AndreaFilippini/QLockTwo-Italian/Images/BackMatrix.jpg

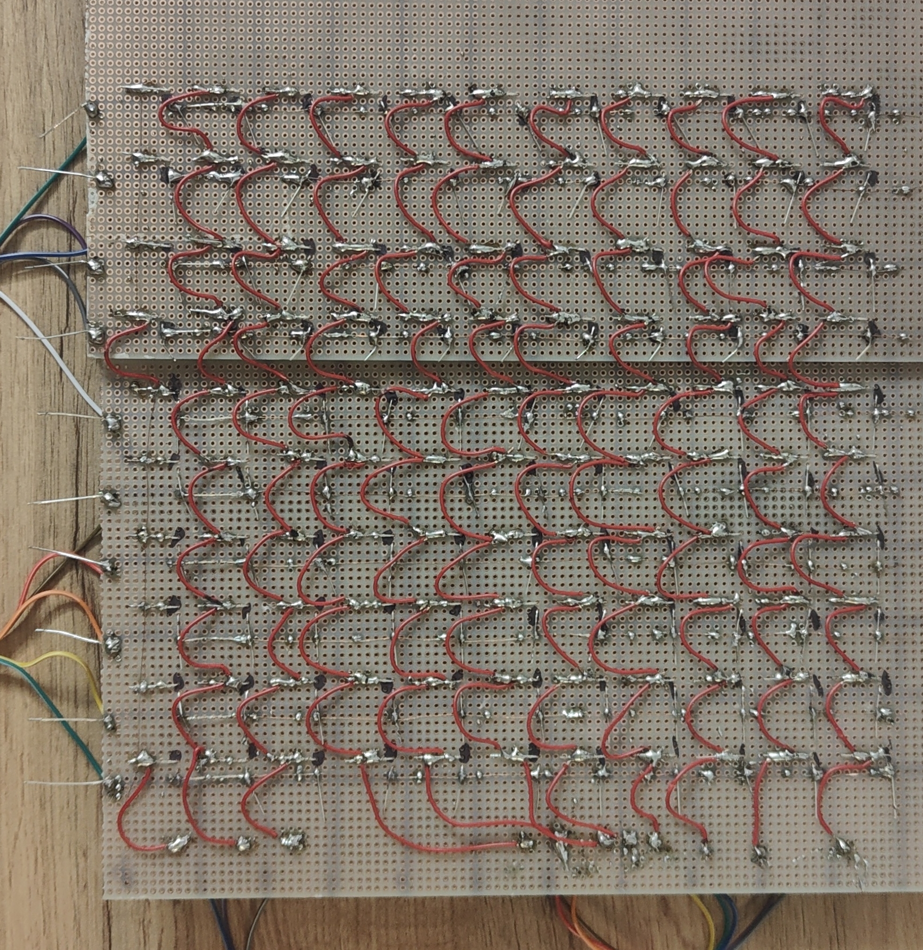
Images/BackMatrix.jpg
