AndreaFilippini/QLockTwo-Italian/Images/FrontMatrix.jpg

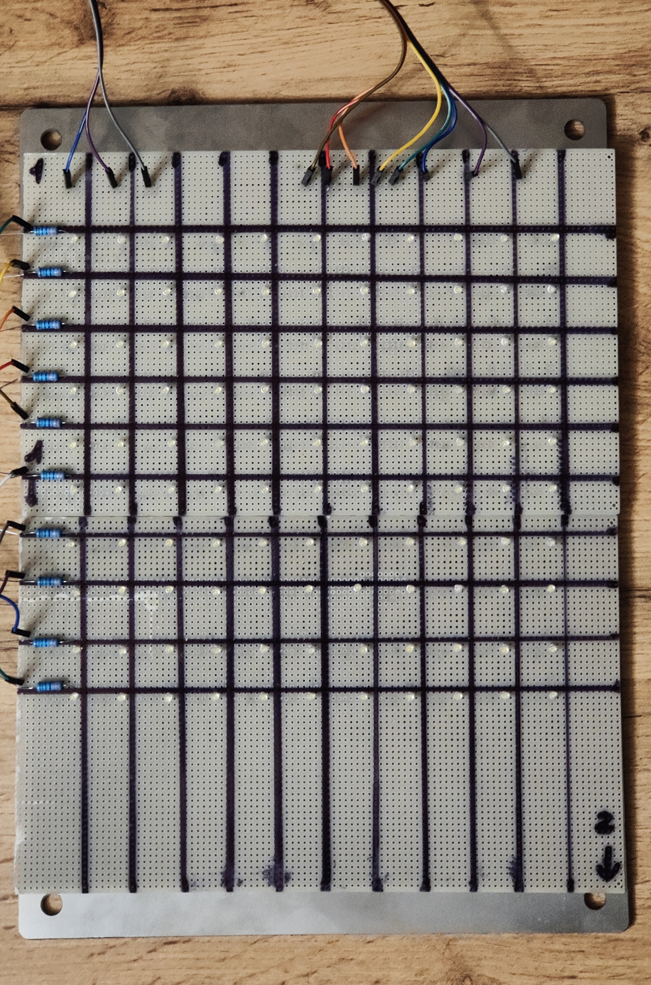
Images/FrontMatrix.jpg
