AndreaFilippini/QLockTwo-Italian/QlockFront.png

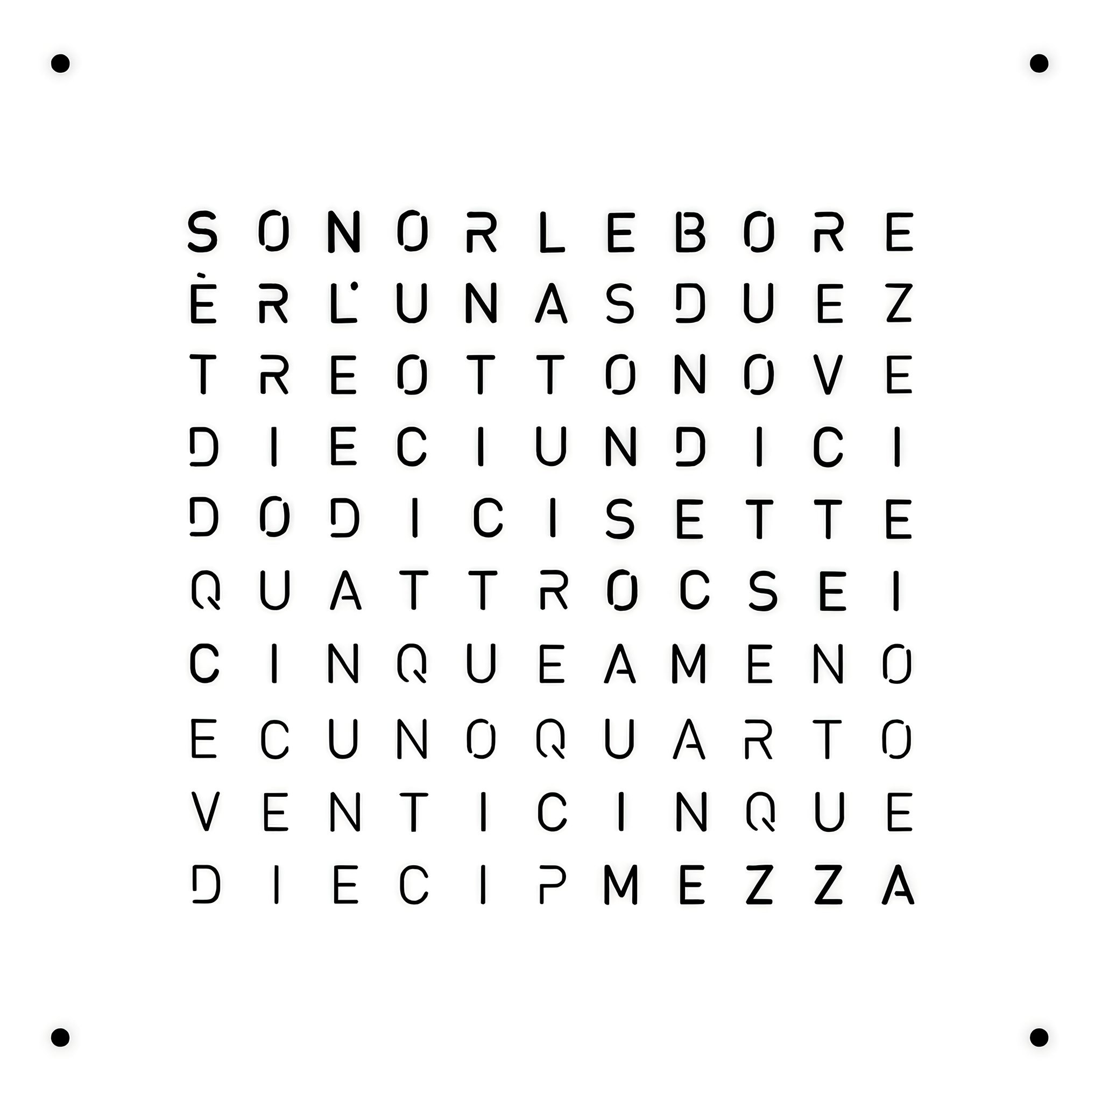
QlockFront.png
