AndreaFilippini/QLockTwo-Italian/(commit log)

2026-01-03 Fix special character management
    [Clock.ino]
2026-01-03 Fix negative index search
    [Clock.ino]
2026-01-04 Added minutes LEDs management
2026-01-05 Fix LEDs minutes management
    [Clock.ino]
2026-01-06 Added test function for minutes LEDs
2026-01-06 Fix coloumns mask macro
    [Clock.ino]
